ollyIsConfused/SteroLautsprecherBau/rohr_stopfen.stl

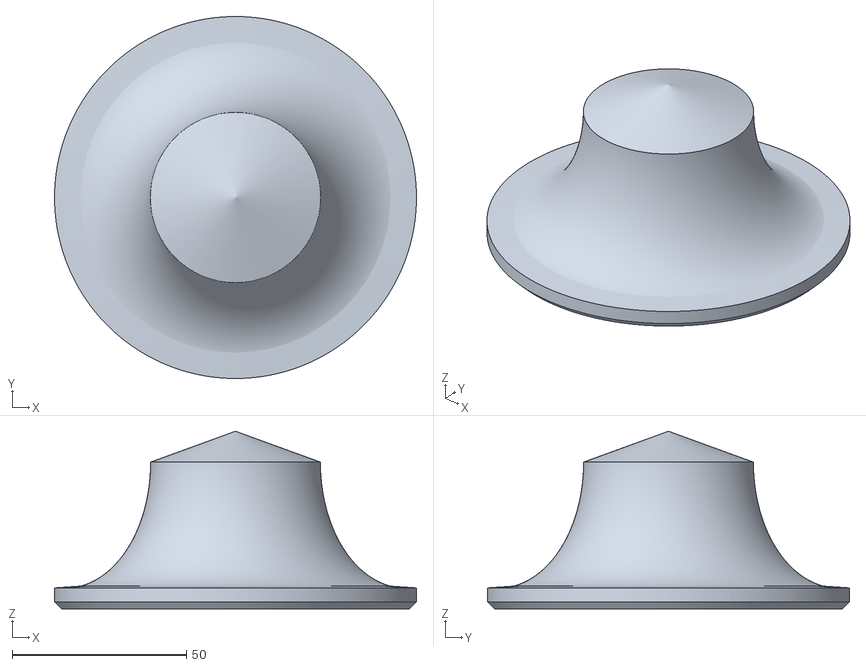
[picture p4: CAD file, 2026-11-10]
rohr_stopfen.stl
104.0 x 104.0 x 51.0
