ollyIsConfused/SteroLautsprecherBau/rohr_muffe.stl

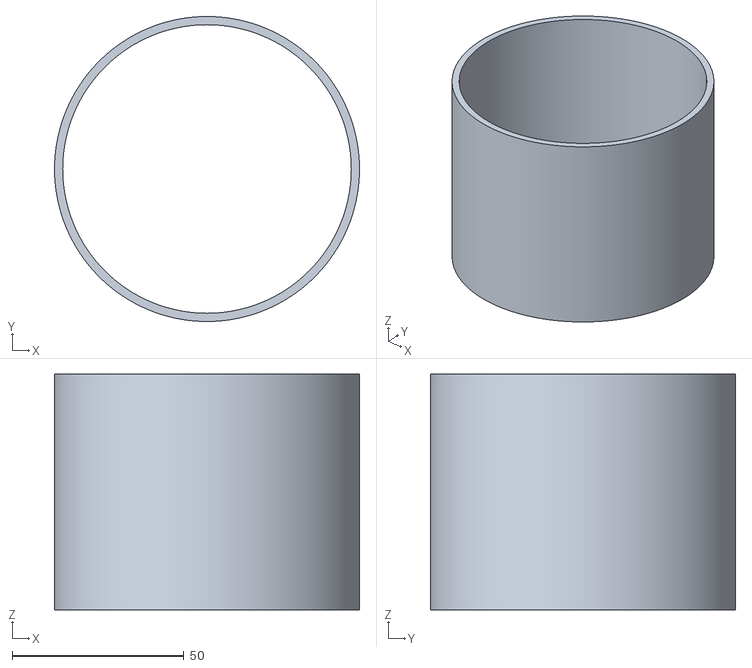
[picture p5: CAD file, 2026-11-10]
rohr_muffe.stl
88.8 x 88.8 x 68.6
