ollyIsConfused/SteroLautsprecherBau/rohr_aussen.stl

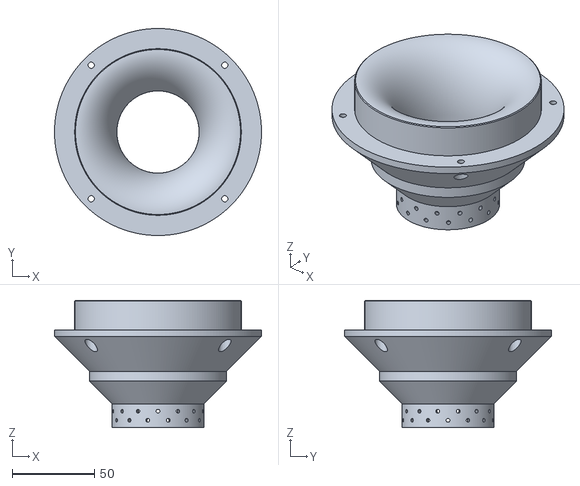
[picture p6: CAD file, 2026-11-10]
rohr_aussen.stl
126.0 x 126.0 x 77.5
