ollyIsConfused/SteroLautsprecherBau/rohr_innen.stl

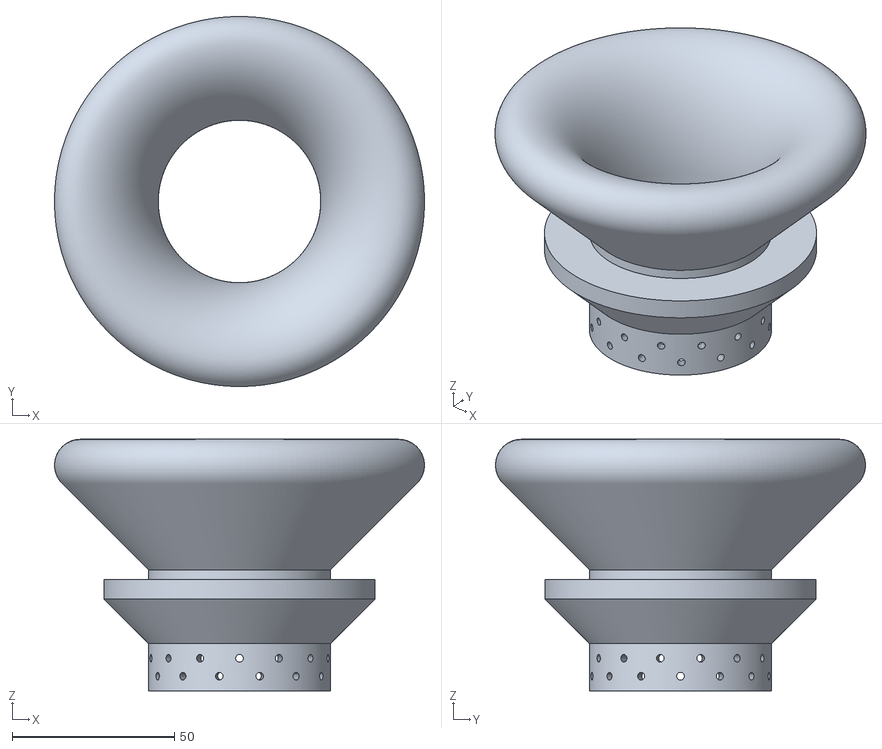
[picture p7: CAD file, 2026-11-10]
rohr_innen.stl
114.0 x 114.0 x 77.5
