ollyIsConfused/SteroLautsprecherBau/rohr_profil.scad

// AUTOMATISCH ERZEUGT von rohr_aerodynamik.py – nicht von Hand aendern.
// Innenkontur und Masse des Sanduhr-Bassreflexrohrs (mm).
rp_L = 155.0; rp_platte = 18.0;
rp_rt = 25.000; rp_rm = 49.0; rp_trichter_l = 36.137;
rp_wand = 3.0; rp_r_zyl = 50.7; rp_r_fl = 63.0; rp_fl_h = 4.0;
rp_r_land = 41.8; rp_land_h = 6.0; rp_muffe_ri = 42.0; rp_muffe_w = 2.4;
rp_nase = 8.0; rp_loch_d = 2.4; rp_loch_s = [4.5, 10.0]; rp_loch_n = 14;
rp_fb = 44.65; rp_netto_l = 17.839; rp_vol_l = 0.949;
rp_f_rohr = 1058; rp_f_falle = 1052; rp_kc = 0.562;
// [s, r]: s = 0 Mund aussen (buendig mit der Rueckwand) ... s = rp_L Mund innen
rp_bohrung = [[0.000, 49.000], [0.001, 48.860], [0.003, 48.719], [0.006, 48.577], [0.011, 48.434], [0.018, 48.290], [0.025, 48.146], [0.035, 48.001], [0.046, 47.855], [0.058, 47.709], [0.072, 47.561], [0.087, 47.413], [0.104, 47.264], [0.123, 47.114], [0.143, 46.964], [0.165, 46.813], [0.188, 46.661], [0.213, 46.508], [0.240, 46.354], [0.269, 46.200], [0.299, 46.045], [0.331, 45.889], [0.365, 45.733], [0.400, 45.575], [0.438, 45.418], [0.477, 45.259], [0.518, 45.099], [0.561, 44.939], [0.606, 44.778], [0.652, 44.617], [0.701, 44.455], [0.752, 44.292], [0.804, 44.128], [0.859, 43.964], [0.916, 43.799], [0.974, 43.633], [1.035, 43.467], [1.098, 43.300], [1.163, 43.132], [1.231, 42.964], [1.300, 42.795], [1.372, 42.625], [1.446, 42.455], [1.522, 42.284], [1.601, 42.112], [1.682, 41.940], [1.765, 41.767], [1.851, 41.594], [1.939, 41.420], [2.030, 41.246], [2.123, 41.071], [2.219, 40.895], [2.317, 40.719], [2.418, 40.542], [2.521, 40.365], [2.628, 40.187], [2.736, 40.009], [2.848, 39.830], [2.963, 39.650], [3.080, 39.471], [3.200, 39.290], [3.323, 39.110], [3.449, 38.928], [3.578, 38.747], [3.710, 38.565], [3.845, 38.382], [3.983, 38.200], [4.125, 38.016], [4.269, 37.833], [4.417, 37.649], [4.568, 37.465], [4.722, 37.280], [4.880, 37.095], [5.041, 36.910], [5.205, 36.725], [5.373, 36.539], [5.545, 36.354], [5.720, 36.168], [5.899, 35.981], [6.082, 35.795], [6.268, 35.609], [6.459, 35.422], [6.653, 35.236], [6.851, 35.049], [7.053, 34.863], [7.259, 34.676], [7.469, 34.490], [7.683, 34.303], [7.901, 34.117], [8.124, 33.931], [8.351, 33.745], [8.582, 33.559], [8.818, 33.373], [9.058, 33.188], [9.303, 33.003], [9.552, 32.819], [9.806, 32.634], [10.065, 32.451], [10.328, 32.268], [10.596, 32.085], [10.870, 31.903], [11.148, 31.722], [11.431, 31.541], [11.719, 31.361], [12.012, 31.182], [12.310, 31.004], [12.614, 30.827], [12.923, 30.650], [13.237, 30.475], [13.556, 30.301], [13.881, 30.128], [14.212, 29.956], [14.547, 29.786], [14.889, 29.617], [15.236, 29.450], [15.588, 29.284], [15.946, 29.120], [16.310, 28.958], [16.680, 28.797], [17.055, 28.638], [17.436, 28.482], [17.823, 28.327], [18.215, 28.175], [18.613, 28.025], [19.017, 27.877], [19.427, 27.731], [19.842, 27.589], [20.263, 27.449], [20.690, 27.312], [21.122, 27.177], [21.560, 27.046], [22.003, 26.918], [22.452, 26.793], [22.906, 26.671], [23.365, 26.553], [23.830, 26.438], [24.300, 26.327], [24.775, 26.220], [25.254, 26.116], [25.738, 26.017], [26.227, 25.921], [26.721, 25.830], [27.219, 25.743], [27.720, 25.661], [28.226, 25.583], [28.736, 25.509], [29.249, 25.440], [29.765, 25.376], [30.285, 25.317], [30.807, 25.263], [31.333, 25.213], [31.860, 25.169], [32.390, 25.129], [32.922, 25.095], [33.455, 25.066], [33.990, 25.042], [34.525, 25.024], [35.062, 25.011], [35.599, 25.003], [36.137, 25.000], [77.500, 25.000], [118.863, 25.000], [119.401, 25.003], [119.938, 25.011], [120.475, 25.024], [121.010, 25.042], [121.545, 25.066], [122.078, 25.095], [122.610, 25.129], [123.140, 25.169], [123.667, 25.213], [124.193, 25.263], [124.715, 25.317], [125.235, 25.376], [125.751, 25.440], [126.264, 25.509], [126.774, 25.583], [127.280, 25.661], [127.781, 25.743], [128.279, 25.830], [128.773, 25.921], [129.262, 26.017], [129.746, 26.116], [130.225, 26.220], [130.700, 26.327], [131.170, 26.438], [131.635, 26.553], [132.094, 26.671], [132.548, 26.793], [132.997, 26.918], [133.440, 27.046], [133.878, 27.177], [134.310, 27.312], [134.737, 27.449], [135.158, 27.589], [135.573, 27.731], [135.983, 27.877], [136.387, 28.025], [136.785, 28.175], [137.177, 28.327], [137.564, 28.482], [137.945, 28.638], [138.320, 28.797], [138.690, 28.958], [139.054, 29.120], [139.412, 29.284], [139.764, 29.450], [140.111, 29.617], [140.453, 29.786], [140.788, 29.956], [141.119, 30.128], [141.444, 30.301], [141.763, 30.475], [142.077, 30.650], [142.386, 30.827], [142.690, 31.004], [142.988, 31.182], [143.281, 31.361], [143.569, 31.541], [143.852, 31.722], [144.130, 31.903], [144.404, 32.085], [144.672, 32.268], [144.935, 32.451], [145.194, 32.634], [145.448, 32.819], [145.697, 33.003], [145.942, 33.188], [146.182, 33.373], [146.418, 33.559], [146.649, 33.745], [146.876, 33.931], [147.099, 34.117], [147.317, 34.303], [147.531, 34.490], [147.741, 34.676], [147.947, 34.863], [148.149, 35.049], [148.347, 35.236], [148.541, 35.422], [148.732, 35.609], [148.918, 35.795], [149.101, 35.981], [149.280, 36.168], [149.455, 36.354], [149.627, 36.539], [149.795, 36.725], [149.959, 36.910], [150.120, 37.095], [150.278, 37.280], [150.432, 37.465], [150.583, 37.649], [150.731, 37.833], [150.875, 38.016], [151.017, 38.200], [151.155, 38.382], [151.290, 38.565], [151.422, 38.747], [151.551, 38.928], [151.677, 39.110], [151.800, 39.290], [151.920, 39.471], [152.037, 39.650], [152.152, 39.830], [152.264, 40.009], [152.372, 40.187], [152.479, 40.365], [152.582, 40.542], [152.683, 40.719], [152.781, 40.895], [152.877, 41.071], [152.970, 41.246], [153.061, 41.420], [153.149, 41.594], [153.235, 41.767], [153.318, 41.940], [153.399, 42.112], [153.478, 42.284], [153.554, 42.455], [153.628, 42.625], [153.700, 42.795], [153.769, 42.964], [153.837, 43.132], [153.902, 43.300], [153.965, 43.467], [154.026, 43.633], [154.084, 43.799], [154.141, 43.964], [154.196, 44.128], [154.248, 44.292], [154.299, 44.455], [154.348, 44.617], [154.394, 44.778], [154.439, 44.939], [154.482, 45.099], [154.523, 45.259], [154.562, 45.418], [154.600, 45.575], [154.635, 45.733], [154.669, 45.889], [154.701, 46.045], [154.731, 46.200], [154.760, 46.354], [154.787, 46.508], [154.812, 46.661], [154.835, 46.813], [154.857, 46.964], [154.877, 47.114], [154.896, 47.264], [154.913, 47.413], [154.928, 47.561], [154.942, 47.709], [154.954, 47.855], [154.965, 48.001], [154.975, 48.146], [154.982, 48.290], [154.989, 48.434], [154.994, 48.577], [154.997, 48.719], [154.999, 48.860], [155.000, 49.000]];
