ollyIsConfused/SteroLautsprecherBau/(commit log)

2026-11-10 Replace port with flow-engineered hourglass design (3 printed parts)
    The bass reflex port is now an hourglass: throat 50 mm, both mouths
    98 mm, 155 mm long, mounted from inside and flush with the rear panel.
    Designed by rohr_aerodynamik.py:
    - Flare contour holds curvature radius x area constant, so the
    separation margin (Keulegan-Carpenter number ~0.56) is uniform
    along the whole flare at full excursion
    - Tuning (44.7 Hz at 17.8 L net) computed from an axisymmetric
    potential-flow finite-volume model including both end fields;
    cross-checked against a 1D estimate and a finer grid
    - Rolled-back lip (8 mm, 135 degrees) on the inner mouth
    - Damped Helmholtz trap (4 rows of 14 holes into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
    [bassreflexrohr.stl, lautsprecherbox.scad, rohr_aussen.stl, rohr_innen.stl, rohr_muffe.stl, rohr_profil.scad, trichter_innen.stl]
2026-11-10 Fit the design to the Hertz K 165 Fan Edition drivers
    Datasheet values from the owner: 165 mm woofer with 116 mm cutout
    and 45 mm mounting depth, 24 mm tweeter, 4 ohm, 50 W RMS / 300 W
    peak, 92 dB, crossover (6 dB/oct) included with the set.
    - Woofer cutout 144 -> 116 mm, preview depth 45 mm
    - README: driver section, supplied crossover replaces the DIY
    capacitor advice, closed-box recommendation for this high-Qts
    car driver (sealed 17.8 L gives Qtc ~0.8)
    - New printed part D (rohr_stopfen.stl): contour-matched plug
    that closes the port for sealed operation, removable for a
    future low-Qts hifi woofer
    Claude-Session: https://clau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
    [lautsprecherbox.scad, rohr_stopfen.stl]
2026-11-10 Add step-by-step build guide; default to the sealed build
    - BAUPLAN.md: instruction-style guide from shopping list to
    listening test, written for the sealed Hertz K 165 build with
    the owner's damping material
    - bauplan.py/bauplan.png: dimensioned workshop drawing (front,
    rear, top section, damping scheme; left box, right mirrored)
    - lautsprecherbox.scad: new `bauart` switch, default "geschlossen"
    (no 102 mm rear hole, no port in preview, full rear damping);
    "bassreflex" restores the engineered port
    - README: sealed build is the default, port section kept as the
    documented option; placement and leak-test notes updated
    Claude-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
    [lautsprecherbox.scad]
2026-11-10 Drop the discarded display model; move the speaker project to the root
    The old display-model idea is abandoned. The repository is now the
    speaker project itself, so its README, build guide, model, analysis
    and print files live at the root and show on the repo front page.
    Claude-Session: https://claude.ai/code/session_01BoBJRLv7V6suyTzUotHVaK
    [anschauungsmodell.scad, anschauungsmodell.stl, lautsprecherbox.scad, rohr_aussen.stl, rohr_innen.stl, rohr_muffe.stl, rohr_profil.scad, rohr_stopfen.stl]
